retsyx/mg24-matter-thread-ble-esd/hw/board/mfr/xiao-bma400-drill-report.txt

Drill report for xiao-bma400.kicad_pcb
Created on 2026-10-06T09:21:22

Copper Layer Stackup:
    =============================================================
    L1 :  F.Cu                      front
    L2 :  B.Cu                      back

Drill file 'xiao-bma400-PTH.drl' contains
    plated through holes:
    =============================================================
    T1  0.300mm  0.0118"  (20 holes))
    T2  0.750mm  0.0295"  (2 holes))

    Total plated holes count 22

Drill file 'xiao-bma400-NPTH.drl' contains
    unplated through holes:
    =============================================================
    T1  2.200mm  0.0866"  (2 holes))

    Total unplated holes count 2
