retsyx/mg24-matter-thread-ble-esd/hw/board/bom.csv

References | Quantity | Value or description | Footprint | Manufacturer | Manufacturer part number | Tolerance | Voltage rating | Dielectric | Power rating | Datasheet (local PDF) | Datasheet URL | Supplier | Supplier part number | Purchase URL | Stock shown (snapshot only) | Availability checked on | Assembly | On board | Purchased | Notes
U1 | 1 | XIAO MG24 | Board:XIAO_MG24_SMD | Seeed Studio | 102010590 |  |  |  |  | datasheets/seeed-xiao-mg24-schematic.pdf | https://files.seeedstudio.com/wiki/XIAO_MG24/Getting_Start/XIAO_MG24_SCH.pdf | Seeed Studio | 102010590 | https://www.seeedstudio.com/Seeed-Studio-XIAO-MG24-p-6247.html |  |  | SMD reflow | True | True | Standard XIAO MG24, headers not soldered. Solder 14 edge contacts and underside BAT+ pad 31 / BAT- pad 32 to carrier; other underside contacts are omitted. USB faces the carrier USB label. Native firmware measures battery voltage through the module onboard switched PD3/PD4 divider. Module identity verified from Seeed sources on 2026-10-06; inventory was not rechecked.
U2 | 1 | BMA400 | Board:LGA-12_2x2mm_P0.5mm | Bosch Sensortec | BMA400 |  |  |  |  | datasheets/bosch-bma400.pdf | https://www.bosch-sensortec.com/media/boschsensortec/downloads/datasheets/bst-bma400-ds000.pdf | LCSC | C437655 | https://www.lcsc.com/product-detail/C437655.html | 110 | 2026-10-05 | SMD reflow | True | True | Bare LGA-12, 2x2mm; I2C address 0x14; align pin 1. LCSC listed stock; Bosch franchise status was not verified. DigiKey 828-1081-1-ND and Mouser 262-BMA400 showed no stock on the check date.
J1 | 1 | JST PH 2.0mm horizontal 2-pin battery connector | Board:JST_PH_S2B-PH-K_1x02_P2.00mm_Horizontal | JST | S2B-PH-K-S(LF)(SN) |  |  |  |  | datasheets/jst-ph.pdf | https://www.jst-mfg.com/product/pdf/eng/ePH.pdf | DigiKey | 455-1719-ND | https://www.digikey.com/en/products/detail/jst-sales-america-inc/S2B-PH-K-S/926626 | 644136 | 2026-10-05 | Through-hole | True | True | Horizontal/right-angle PH 2.00mm pitch, two positions; opening faces the bottom board edge. Pin 1 GND negative; pin 2 VBAT positive. DigiKey displays the shortened MPN S2B-PH-K-S; LF/SN finish suffix is documented by JST.
R1,R2 | 2 | 10k | Board:R_0603_1608Metric | Panasonic Industry | ERJ-3EKF1002V | 1% |  |  | 0.1W | datasheets/panasonic-erj-thick-film.pdf | https://industrial.panasonic.com/cdbs/www-data/pdf/RDA0000/AOA0000C304.pdf | DigiKey | P10.0KHCT-ND | https://www.digikey.com/en/products/detail/panasonic-industry/ERJ-3EKF1002V/198102 | 2918667 | 2026-10-05 | SMD 0603 | True | True | 10kohm, 1%, 0.1W, 0603 (1608 metric); I2C pullups to 3V3. Stock figure came from a supplier page cached approximately three weeks before the check date.
C1,C2 | 2 | 100nF | Board:C_0603_1608Metric | KEMET | C0603C104K5RACTU | 10% | 50V | X7R |  | datasheets/kemet-x7r-smd.pdf | https://yageogroup.com/content/datasheet/asset/file/KEM_C1002_X7R_SMD | DigiKey | 399-C0603C104K5RACTUCT-ND | https://www.digikey.com/en/products/detail/kemet/C0603C104K5RACTU/1465623 | 4862323 | 2026-10-05 | SMD 0603 | True | True | 100nF, 50V, X7R, 10%, 0603 (1608 metric); C1 VDDIO bypass and C2 VDD bypass.
C3 | 1 | 1uF | Board:C_0603_1608Metric | KEMET | C0603C105K4RACTU | 10% | 16V | X7R |  | datasheets/kemet-x7r-smd.pdf | https://yageogroup.com/content/datasheet/asset/file/KEM_C1002_X7R_SMD | DigiKey | 399-C0603C105K4RACTUCT-ND | https://www.digikey.com/en/products/detail/kemet/C0603C105K4RACTU/2199788 | 3654352 | 2026-10-05 | SMD 0603 | True | True | 1uF, 16V, X7R, 10%, 0603 (1608 metric); 3V3 bulk bypass.
External battery | 1 | Protected 1S LiPo, 500mAh, 3.7V nominal, 4.2V maximum; plug polarity reversal required |  | Adafruit Industries | 1578 |  |  |  |  | datasheets/adafruit-1578-battery.pdf | https://cdn-shop.adafruit.com/product-files/1578/Datasheet.pdf | DigiKey | 1528-1841-ND | https://www.digikey.com/en/products/detail/adafruit-industries-llc/1578/5054539 | 3086 | 2026-10-05 | External assembly; plug polarity reversal required | False | True | Protected rechargeable 500mAh pack with JST PH 2.0mm plug; included specification permits up to 1C (500mA) charging, exceeding the XIAO MG24 nominal 200mA charger. Stock plug polarity is opposite to carrier J1. Use a polarity-reversing adapter or correctly repinned connector: battery negative to J1 pin 1, positive to pin 2. Verify final plug polarity before connection. Keep pack away from antenna.
H1,H2 | 2 | 2.2mm mounting hole | Board:MountingHole_2.2mm_M2 |  |  |  |  |  |  |  |  |  |  |  |  |  | PCB feature only | False | False | PCB holes, not purchased components; enclosure-specific M2 hardware is not included.
