retsyx/mg24-matter-thread-ble-esd/hw/board/3dmodels/XIAO_MG24.step

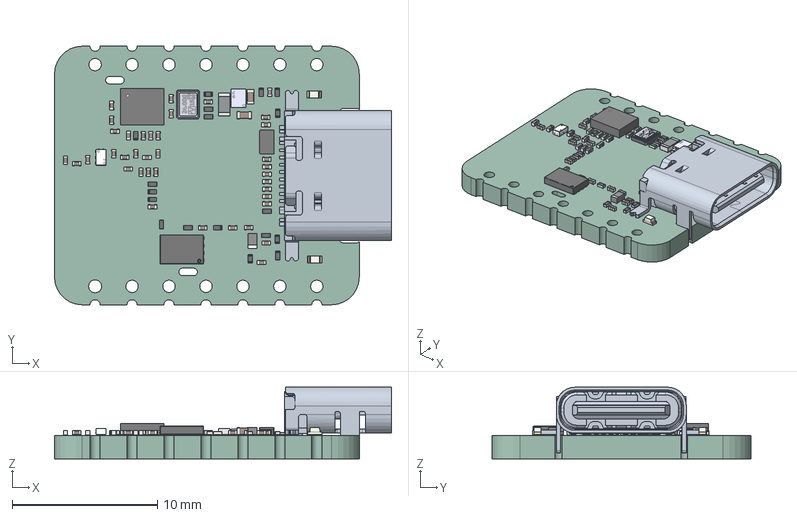
[picture p2: CAD file, 2026-10-09]
hw/board/3dmodels/XIAO_MG24.step
23.2 x 17.8 x 4.93 mm
C_0201_0603Metric x 32
R_0201_0603Metric x 18
L_0201_0603Metric x 6
LED_0402_1005Metric x 2
TYPE-C_16P_
EB6ED80E-EAC8-44A4-AAF6-322E8D91BB5F
DFN-1006-2
C_0402_1005Metric x 2
MicroCrystal_CM9V_T1A
06DA10BF-5308-4739-B1F2-25DD20B2B3A8
LGA_14_3x25mm_P05mm_LayoutBorder3x4y
PCBModel x 2
XIAO_MGM240S_KICAD_Prj_PCB
