retsyx/mg24-matter-thread-ble-esd/hw/board/xiao-bma400.kicad_pcb

## KiCad design hw/board/xiao-bma400.kicad_pcb (2026-10-09)

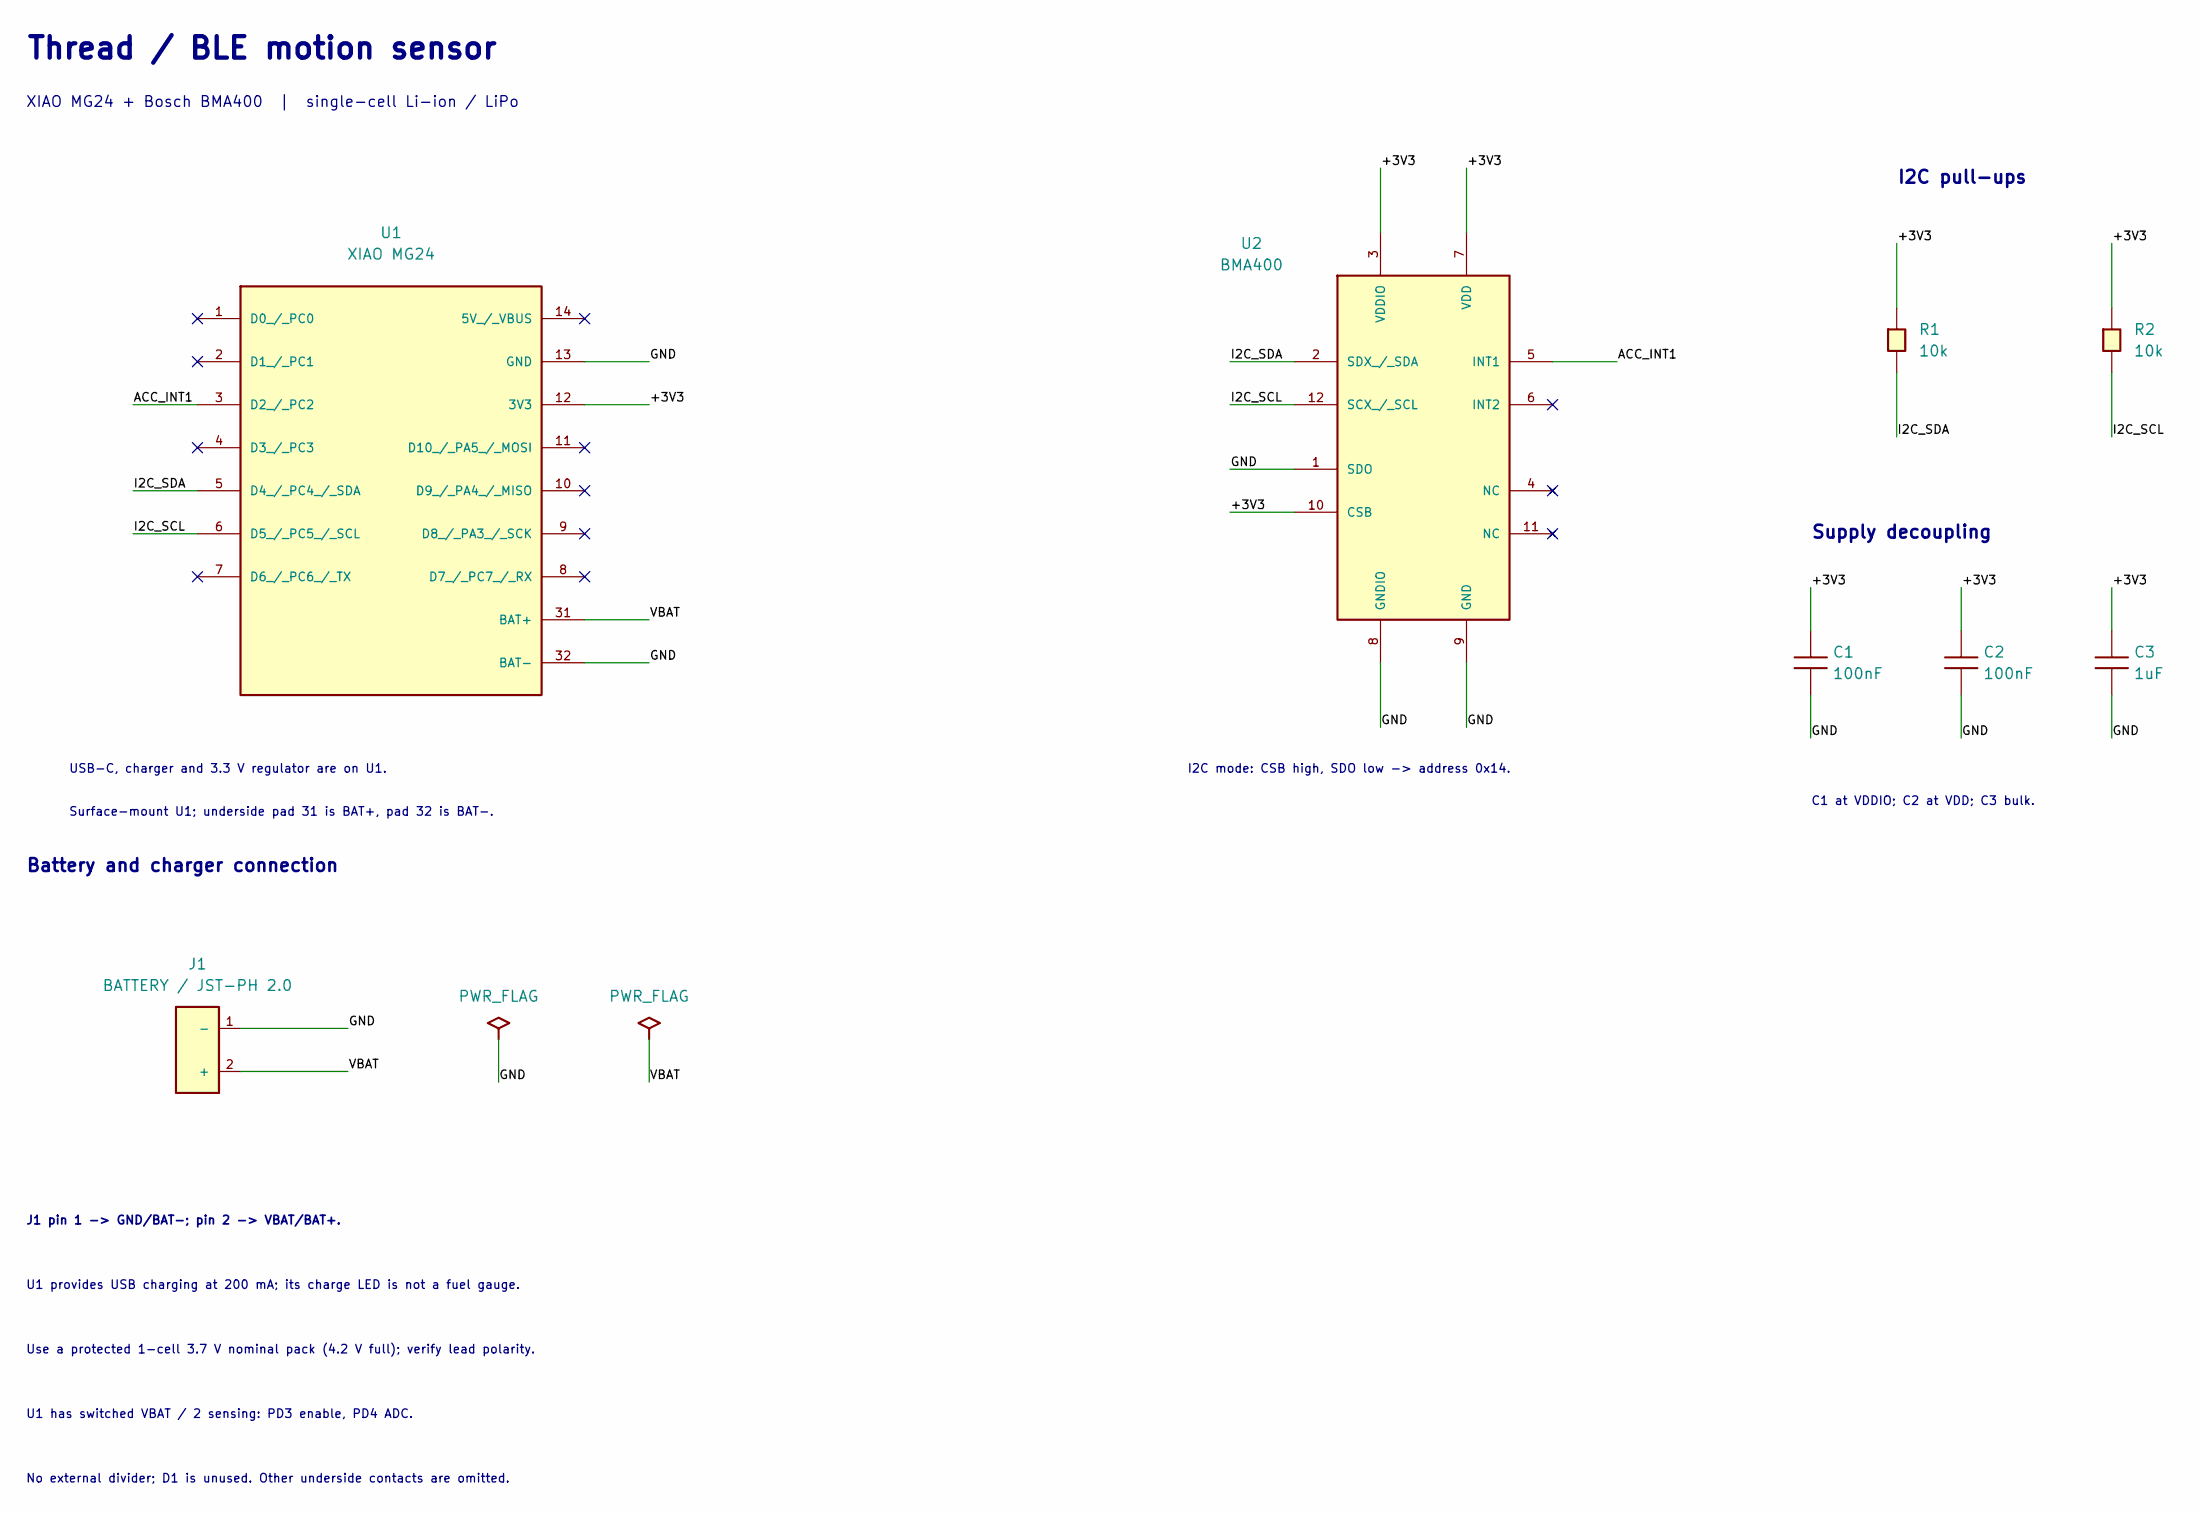
[picture p3: schematic xiao-bma400.kicad_sch, XIAO MG24 / BMA400 Motion Sensor]

Parts:
C1, C2: 100nF; C_0603_1608Metric; Tolerance 10%; Voltage 50V; MPN C0603C104K5RACTU
C3: 1uF; C_0603_1608Metric; Tolerance 10%; Voltage 16V; MPN C0603C105K4RACTU
J1: BATTERY / JST-PH 2.0; JST_PH_S2B-PH-K_1x02_P2.00mm_Horizontal; MPN S2B-PH-K-S(LF)(SN)
R1, R2: 10k; R_0603_1608Metric; Tolerance 1%; MPN ERJ-3EKF1002V
U1: XIAO MG24; XIAO_MG24_SMD; MPN 102010590
U2: BMA400; LGA-12_2x2mm_P0.5mm; MPN BMA400

Connections:
/+3V3: C1.1, C2.1, C3.1, R1.1, R2.1, U1.12 (3V3), U2.3 (VDDIO), U2.7 (VDD), U2.10 (CSB)
/ACC_INT1: U1.3 (D2_/_PC2), U2.5 (INT1)
/GND: C1.2, C2.2, C3.2, J1.1 (-), U1.13 (GND), U1.32 (BAT-), U2.1 (SDO), U2.8 (GNDIO), U2.9 (GND)
/I2C_SCL: R2.2, U1.6 (D5_/_PC5_/_SCL), U2.12 (SCX_/_SCL)
/I2C_SDA: R1.2, U1.5 (D4_/_PC4_/_SDA), U2.2 (SDX_/_SDA)
/VBAT: J1.2 (+), U1.31 (BAT+)

Notes on the sheet:
U1 has switched VBAT / 2 sensing: PD3 enable, PD4 ADC.
C1 at VDDIO; C2 at VDD; C3 bulk.
Battery and charger connection
I2C mode: CSB high, SDO low -> address 0x14.
Use a protected 1-cell 3.7 V nominal pack (4.2 V full); verify lead polarity.
USB-C, charger and 3.3 V regulator are on U1.
J1 pin 1 -> GND/BAT-; pin 2 -> VBAT/BAT+.
XIAO MG24 + Bosch BMA400 | single-cell Li-ion / LiPo
Surface-mount U1; underside pad 31 is BAT+, pad 32 is BAT-.
No external divider; D1 is unused. Other underside contacts are omitted.
Thread / BLE motion sensor
U1 provides USB charging at 200 mA; its charge LED is not a fuel gauge.
Supply decoupling
I2C pull-ups

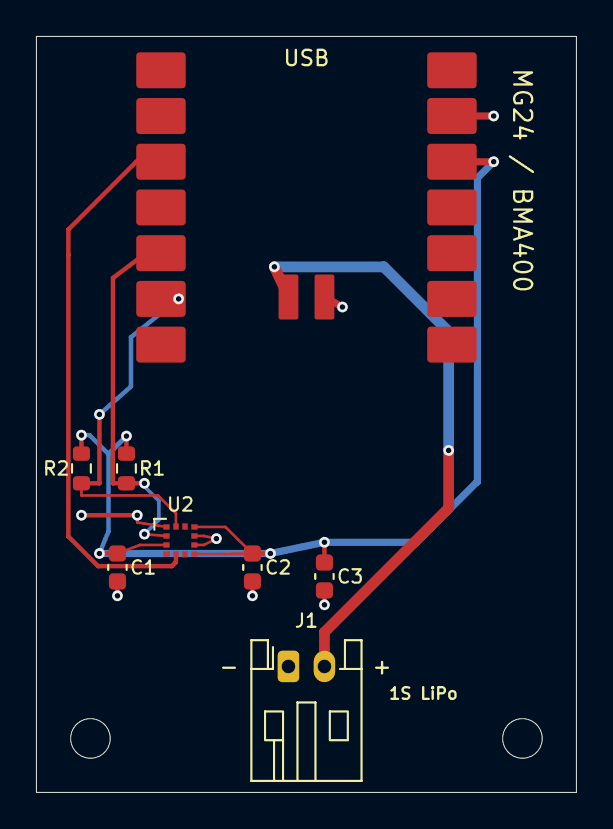
[picture p4: board xiao-bma400.kicad_pcb from above]

Board: 2 copper layers, 30.0 x 42.0 mm, 10 parts (0 on the bottom side), 6 nets.

Other parts of the board:
H1, H2: MountingHole_2.2mm_M2
