retsyx/mg24-matter-thread-ble-esd/include/CHIPProjectConfig.h

/*
 *
 *    Copyright (c) 2020 Project CHIP Authors
 *    Copyright (c) 2019 Google LLC.
 *    All rights reserved.
 *
 *    Licensed under the Apache License, Version 2.0 (the "License");
 *    you may not use this file except in compliance with the License.
 *    You may obtain a copy of the License at
 *
 *        http://www.apache.org/licenses/LICENSE-2.0
 *
 *    Unless required by applicable law or agreed to in writing, software
 *    distributed under the License is distributed on an "AS IS" BASIS,
 *    WITHOUT WARRANTIES OR CONDITIONS OF ANY KIND, either express or implied.
 *    See the License for the specific language governing permissions and
 *    limitations under the License.
 */

/**
 *    @file
 *          Example project configuration file for CHIP.
 *
 *          This is a place to put application or project-specific overrides
 *          to the default configuration values for general CHIP features.
 *
 */

#pragma once

#include <stdint.h>

// Use a default pairing code if one hasn't been provisioned in flash.
#ifndef CHIP_DEVICE_CONFIG_USE_TEST_SETUP_PIN_CODE
#define CHIP_DEVICE_CONFIG_USE_TEST_SETUP_PIN_CODE 20202021
#endif

#ifndef CHIP_DEVICE_CONFIG_USE_TEST_SETUP_DISCRIMINATOR
#define CHIP_DEVICE_CONFIG_USE_TEST_SETUP_DISCRIMINATOR 0xF00
#endif

// For convenience, Chip Security Test Mode can be enabled and the
// requirement for authentication in various protocols can be disabled.
//
//    WARNING: These options make it possible to circumvent basic Chip security functionality,
//    including message encryption. Because of this they MUST NEVER BE ENABLED IN PRODUCTION BUILDS.
//
#define CHIP_CONFIG_SECURITY_TEST_MODE 0

/**
 * CHIP_DEVICE_CONFIG_DEVICE_VENDOR_ID
 *
 * 0xFFF1: Test vendor
 */
#define CHIP_DEVICE_CONFIG_DEVICE_VENDOR_ID 0xFFF1

/**
 * CHIP_DEVICE_CONFIG_DEVICE_PRODUCT_ID
 *
 * 0x8004: mailbox motion sensor
 */
#define CHIP_DEVICE_CONFIG_DEVICE_PRODUCT_ID 0x8004

/**
 * CHIP_DEVICE_CONFIG_ENABLE_CHIPOBLE
 *
 * Enable support for Chip-over-BLE (CHIPoBLE).
 */
#define CHIP_DEVICE_CONFIG_ENABLE_CHIPOBLE 1

/**
 * CHIP_DEVICE_CONFIG_TEST_SERIAL_NUMBER
 *
 * Enables the use of a hard-coded default serial number if none
 * is found in Chip NV storage.
 */
#define CHIP_DEVICE_CONFIG_TEST_SERIAL_NUMBER "XIAO_MG24_MAILBOX"

/**
 * CHIP_DEVICE_CONFIG_EVENT_LOGGING_UTC_TIMESTAMPS
 *
 * Enable recording UTC timestamps.
 */
#define CHIP_DEVICE_CONFIG_EVENT_LOGGING_UTC_TIMESTAMPS 1

/**
 * CHIP_DEVICE_CONFIG_EVENT_LOGGING_DEBUG_BUFFER_SIZE
 *
 * A size, in bytes, of the individual debug event logging buffer.
 */
#define CHIP_DEVICE_CONFIG_EVENT_LOGGING_DEBUG_BUFFER_SIZE (512)

/**
 *  @def CHIP_CONFIG_MRP_LOCAL_ACTIVE_RETRY_INTERVAL
 *
 *  @brief
 *    Active retransmit interval, or time to wait before retransmission after
 *    subsequent failures in milliseconds.
 *
 *  This is the default value, that might be adjusted by end device depending on its
 *  needs (e.g. sleeping period) using Service Discovery TXT record CRA key.
 *
 */
#define CHIP_CONFIG_MRP_LOCAL_ACTIVE_RETRY_INTERVAL (2000_ms32)
