retsyx/mg24-matter-thread-ble-esd/src/DataModelCallbacks.cpp

// SPDX-License-Identifier: Apache-2.0
#include <app/ConcreteAttributePath.h>

void MatterPostAttributeChangeCallback(const chip::app::ConcreteAttributePath &,
                                     uint8_t, uint16_t, uint8_t *)
{}
