retsyx/mg24-matter-thread-ble-esd/(commit log)

2026-10-16 Power consumption reduction, and measurement
2026-10-16 ZAP version pin update
